HugoFishx/Cat_litter_box/README.md

Cat Litter Box + - Final project of ECE473 @ Umich FA 2021
Group:
    Shiqi Yu
    Haoda Gong
    Yechen Shi
    Ruitao Long
    Tianyang Shi
