HugoFishx/Cat_litter_box/PCB/Draft1.brd

## EAGLE design PCB/Draft1.brd (2021-12-13)

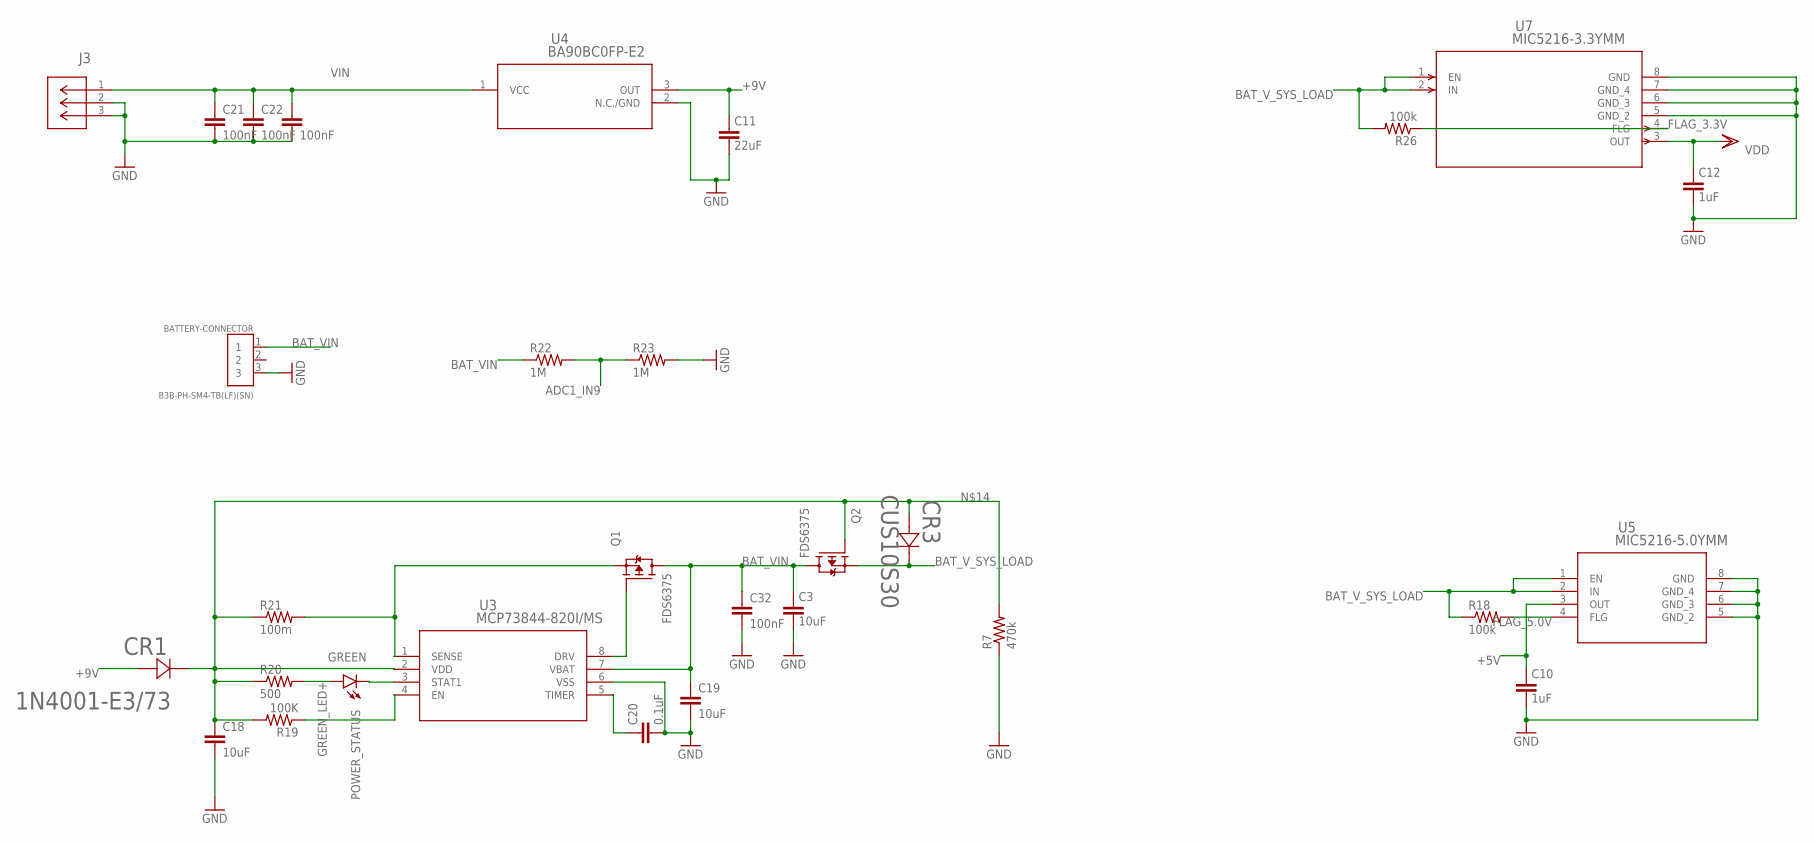
[picture p1: schematic Draft1.sch, sheet 1, Power]

Parts:
BATTERY-CONNECTOR: B3B-PH-SM4-TB(LF)(SN); JST_B3B-PH-SM4-TB(LF)(SN)
C3, C18, C19: 10uF; C0603
C10, C12: 1uF; C0603
C11: 22uF; C0603
C20: 0.1uF; C0603
C21, C22, C23, C32: 100nF; C0603
CR1: 1N4001-E3/73; DO-204AL_VIS
CR3: CUS10S30; USC_TOS
J3: EJ503B; CONN_EJ503B_MPD
POWER_STATUS: GREEN; 1206
Q1, Q2: FDS6375; SOIC127P600X175-8N
R7: 470k; R0603
R18, R26: 100k; R0603
R19: 100K; R0603
R20: 500; R0603
R21: 100m; R0603
R22, R23: 1M; R0603
U3: MCP73844-820I/MS; MSOP8_MC_MCH
U4: BA90BC0FP-E2; TO252-3_ROM
U5: MIC5216-5.0YMM; MSOP8_MM_MCH
U7: MIC5216-3.3YMM; MSOP-8_MM_MCL

Connections:
+5V: C10.1, U5.3 (OUT); also elsewhere on the board
+9V: C11.1, CR1.2, U4.3 (OUT)
ADC1_IN9: R22.2, R23.1; also elsewhere on the board
BAT_VIN: BATTERY-CONNECTOR.1, C3.1, C19.1, C32.1, Q1.5 (D), Q1.6 (D), Q1.7 (D), Q1.8 (D), Q2.5 (D), Q2.6 (D), Q2.7 (D), Q2.8 (D), R22.1, U3.7 (VBAT)
BAT_V_SYS_LOAD: CR3.1 (CATHODE), Q2.1 (S), Q2.2 (S), Q2.3 (S), R18.1, R26.2, U5.1 (EN), U5.2 (IN), U7.1 (EN), U7.2 (IN)
FLAG_3.3V: R26.1, U7.4 (FLG)
FLAG_5.0V: R18.2, U5.4 (FLG)
GND: BATTERY-CONNECTOR.3, C3.2, C10.2, C11.2, C12.2, C18.2, C19.2, C20.2, C21.2, C22.2, C23.2, C32.2, J3.2, J3.3, R7.1, R23.2, U3.6 (VSS), U4.2 (N.C./GND), U5.5 (GND_2), U5.6 (GND_3), U5.7 (GND_4), U5.8 (GND), U7.5 (GND_2), U7.6 (GND_3), U7.7 (GND_4), U7.8 (GND); also elsewhere on the board
GREEN_LED+: POWER_STATUS.A, R20.2
unnamed: C18.1, CR1.1, CR3.2 (ANODE), Q2.4 (G), R7.2, R19.2, R20.1, R21.1, U3.2 (VDD)
unnamed: R19.1, U3.4 (EN)
unnamed: POWER_STATUS.C, U3.3 (STAT1)
unnamed: Q1.4 (G), U3.8 (DRV)
unnamed: Q1.1 (S), Q1.2 (S), Q1.3 (S), R21.2, U3.1 (SENSE)
unnamed: C20.1, U3.5 (TIMER)
VDD: C12.1, U7.3 (OUT); also elsewhere on the board
VIN: C21.1, C22.1, C23.1, J3.1, U4.1 (VCC)

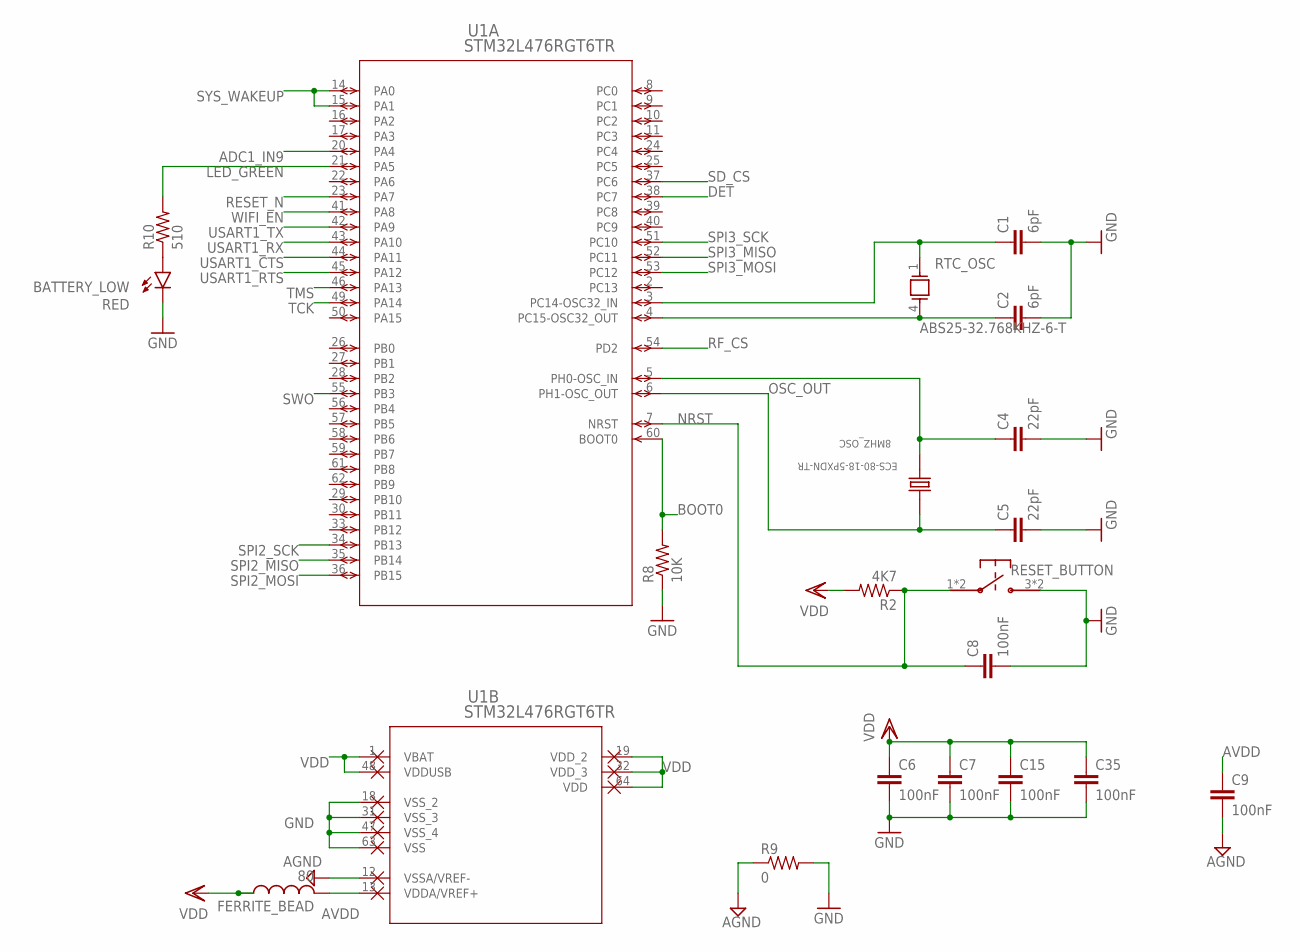
[picture p2: schematic Draft1.sch, sheet 2, MCU]

Parts:
8MHZ_OSC: ECS-80-18-5PXDN-TR; XTAL_ECS-80-18-5PXDN-TR
BATTERY_LOW: RED; 1206
C1, C2: 6pF; C0603
C4, C5: 22pF; C0603
C6, C7, C8, C9, C15, C35: 100nF; C0603
FERRITE_BEAD: 80; L3216C
R2: 4K7; R0603
R8: 10K; R0603
R9: 0; R0603
R10: 510; R0603
RESET_BUTTON: PTS645SM43SMTR
RTC_OSC: ABS25-32.768KHZ-6-T; XTAL_ABS25-32.768KHZ-6-T
U1: STM32L476RGT6TR; LQFP64-10X10MM

Connections:
ADC1_IN9: U1.20 (PA4); also elsewhere on the board
AGND: C9.2, R9.1, U1.12 (VSSA/VREF-)
AVDD: C9.1, FERRITE_BEAD.2, U1.13 (VDDA/VREF+)
BOOT0: R8.2, U1.60 (BOOT0)
DET: U1.38 (PC7); also elsewhere on the board
GND: BATTERY_LOW.C, C1.2, C2.2, C4.2, C5.2, C6.2, C7.2, C8.2, C15.2, C35.2, R8.1, R9.2, RESET_BUTTON.3, RESET_BUTTON.4, U1.18 (VSS_2), U1.31 (VSS_3), U1.47 (VSS_4), U1.63 (VSS); also elsewhere on the board
LED_GREEN: R10.2, U1.21 (PA5)
unnamed: BATTERY_LOW.A, R10.1
unnamed: C1.1, RTC_OSC.1, U1.3 (PC14-OSC32_IN)
unnamed: C2.1, RTC_OSC.4, U1.4 (PC15-OSC32_OUT)
NRST: C8.1, R2.1, RESET_BUTTON.1, RESET_BUTTON.2, U1.7 (NRST); also elsewhere on the board
OSC_IN: 8MHZ_OSC.2, C4.1, U1.5 (PH0-OSC_IN)
OSC_OUT: 8MHZ_OSC.1, C5.1, U1.6 (PH1-OSC_OUT); also elsewhere on the board
RESET_N: U1.23 (PA7); also elsewhere on the board
RF_CS: U1.54 (PD2); also elsewhere on the board
SD_CS: U1.37 (PC6); also elsewhere on the board
SPI2_MISO: U1.35 (PB14); also elsewhere on the board
SPI2_MOSI: U1.36 (PB15); also elsewhere on the board
SPI2_SCK: U1.34 (PB13); also elsewhere on the board
SPI3_MISO: U1.52 (PC11); also elsewhere on the board
SPI3_MOSI: U1.53 (PC12); also elsewhere on the board
SPI3_SCK: U1.51 (PC10); also elsewhere on the board
SWO: U1.55 (PB3); also elsewhere on the board
SYS_WAKEUP: U1.14 (PA0), U1.15 (PA1); also elsewhere on the board
TCK: U1.49 (PA14); also elsewhere on the board
TMS: U1.46 (PA13); also elsewhere on the board
USART1_CTS: U1.44 (PA11); also elsewhere on the board
USART1_RTS: U1.45 (PA12); also elsewhere on the board
USART1_RX: U1.43 (PA10); also elsewhere on the board
USART1_TX: U1.42 (PA9); also elsewhere on the board
VDD: C6.1, C7.1, C15.1, C35.1, FERRITE_BEAD.1, R2.2, U1.1 (VBAT), U1.19 (VDD_2), U1.32 (VDD_3), U1.48 (VDDUSB), U1.64 (VDD); also elsewhere on the board
WIFI_EN: U1.41 (PA8); also elsewhere on the board

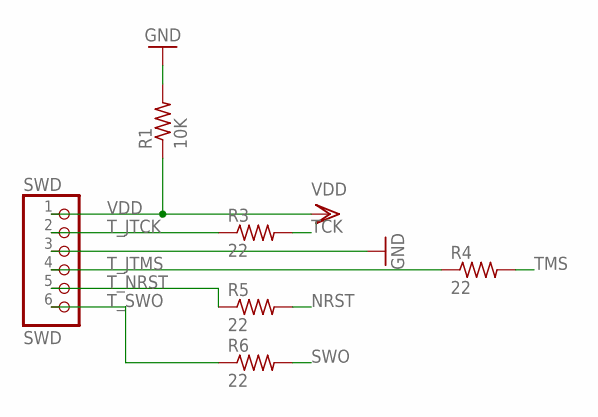
[picture p3: schematic Draft1.sch, sheet 3, STLINK]

Parts:
R1: 10K; R0603
R3, R4, R5, R6: 22; R0603
SWD: SWD; 1X06

Connections:
GND: R1.2, SWD.3; also elsewhere on the board
NRST: R5.2; also elsewhere on the board
SWO: R6.2; also elsewhere on the board
TCK: R3.2; also elsewhere on the board
TMS: R4.2; also elsewhere on the board
T_JTCK: R3.1, SWD.2
T_JTMS: R4.1, SWD.4
T_NRST: R5.1, SWD.5
T_SWO: R6.1, SWD.6
VDD: R1.1, SWD.1; also elsewhere on the board

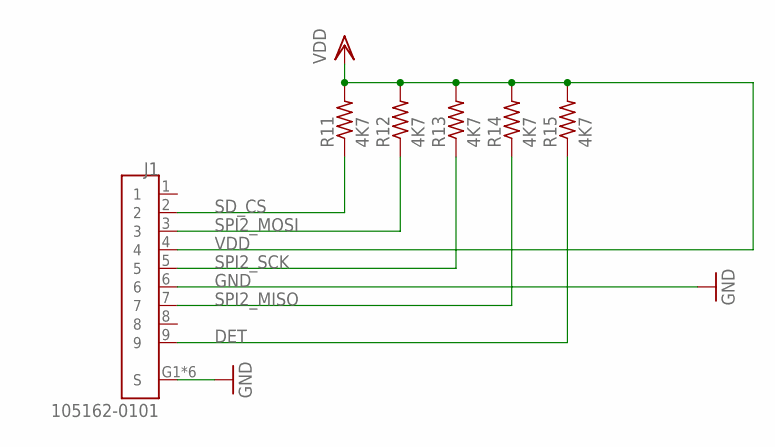
[picture p4: schematic Draft1.sch, sheet 4, microSD]

Parts:
J1: 105162-0101; MOLEX_105162-0101
R11, R12, R13, R14, R15: 4K7; R0603

Connections:
DET: J1.9, R15.1; also elsewhere on the board
GND: J1.6, J1.G1 (S), J1.G2 (S), J1.G3 (S), J1.G4 (S), J1.SH1 (S), J1.SH2 (S); also elsewhere on the board
SD_CS: J1.2, R11.1; also elsewhere on the board
SPI2_MISO: J1.7, R14.1; also elsewhere on the board
SPI2_MOSI: J1.3, R12.1; also elsewhere on the board
SPI2_SCK: J1.5, R13.1; also elsewhere on the board
VDD: J1.4, R11.2, R12.2, R13.2, R14.2, R15.2; also elsewhere on the board

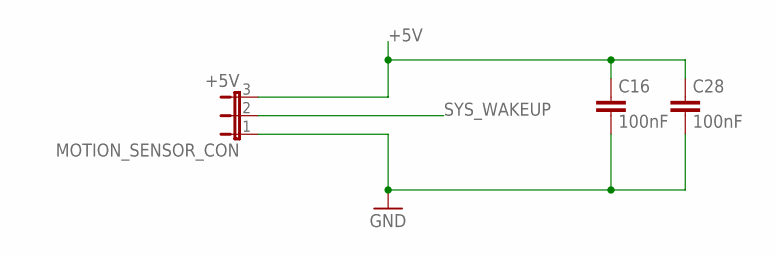
[picture p5: schematic Draft1.sch, sheet 5, Infrared Motion Sensor Connectors]

Parts:
C16, C28: 100nF; C0603
MOTION_SENSOR_CON: +5V; JP2

Connections:
+5V: C16.1, C28.1, MOTION_SENSOR_CON.3; also elsewhere on the board
GND: C16.2, C28.2, MOTION_SENSOR_CON.1; also elsewhere on the board
SYS_WAKEUP: MOTION_SENSOR_CON.2; also elsewhere on the board

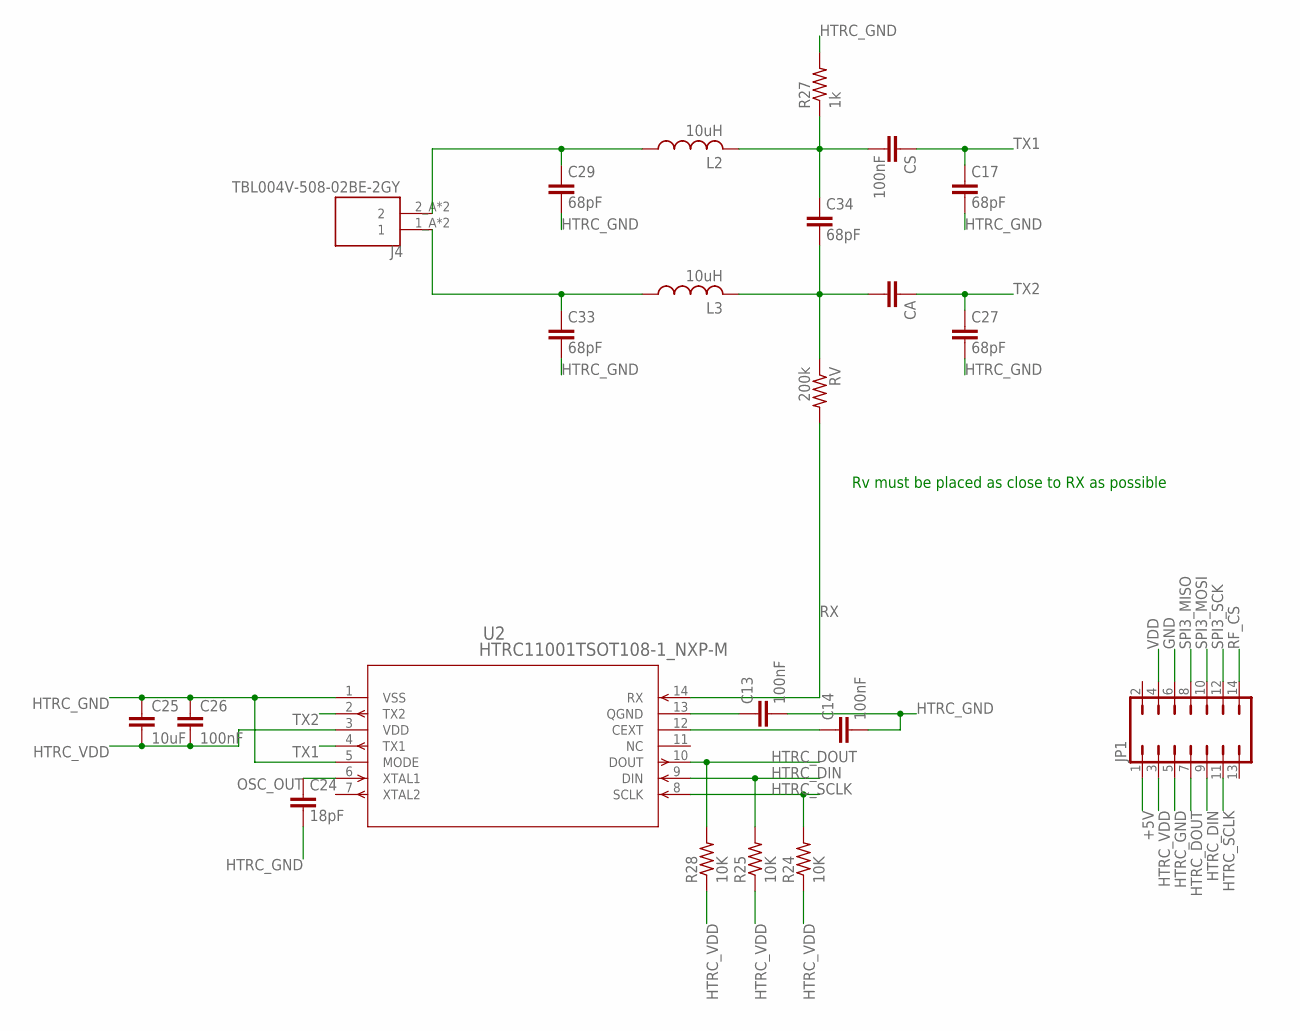
[picture p6: schematic Draft1.sch, sheet 6, RFID Reader]

Parts:
C13, C14, C26: 100nF; C0603
C17, C27, C29, C33, C34: 68pF; C0603
C24: 18pF; C0603
C25: 10uF; C0603
CA: C-EUC0603; C0603
CS: 100nF; C0603
J4: TBL004V-508-02BE-2GY; CUI_TBL004V-508-02BE-2GY
JP1: JP7Q
L2, L3: 10uH; L3225M
R24, R25, R28: 10K; R0603
R27: 1k; R0603
RV: 200k; R0603
U2: HTRC11001TSOT108-1_NXP-M; SOT108-1_NXP-M

Connections:
+5V: JP1.1; also elsewhere on the board
GND: JP1.6; also elsewhere on the board
HTRC_DIN: JP1.9, R25.2, U2.9 (DIN)
HTRC_DOUT: JP1.7, R28.2, U2.10 (DOUT)
HTRC_GND: C13.2, C14.2, C17.2, C24.2, C25.1, C26.1, C27.2, C29.2, C33.2, JP1.5, R27.2, U2.1 (VSS), U2.5 (MODE)
HTRC_SCLK: JP1.11, R24.2, U2.8 (SCLK)
HTRC_VDD: C25.2, C26.2, JP1.3, R24.1, R25.1, R28.1, U2.3 (VDD)
unnamed: C33.1, J4.1_A (1), J4.1_B (1), L3.1
unnamed: C29.1, J4.2_A (2), J4.2_B (2), L2.1
unnamed: C34.1, CS.2, L2.2, R27.1
unnamed: C13.1, U2.13 (QGND)
unnamed: C34.2, CA.2, L3.2, RV.1
unnamed: C14.1, U2.12 (CEXT)
OSC_OUT: C24.1, U2.6 (XTAL1); also elsewhere on the board
RF_CS: JP1.14; also elsewhere on the board
RX: RV.2, U2.14 (RX)
SPI3_MISO: JP1.8; also elsewhere on the board
SPI3_MOSI: JP1.10; also elsewhere on the board
SPI3_SCK: JP1.12; also elsewhere on the board
TX1: C17.1, CS.1, U2.4 (TX1)
TX2: C27.1, CA.1, U2.2 (TX2)
VDD: JP1.4; also elsewhere on the board

Notes on the sheet:
Rv must be placed as close to RX as possible

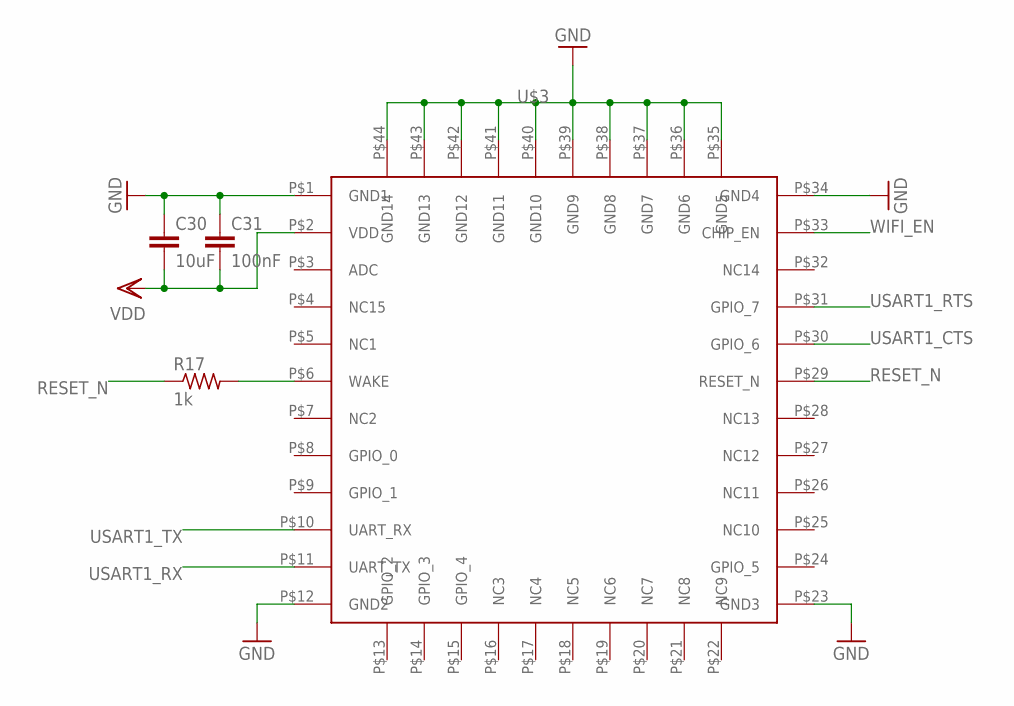
[picture p7: schematic Draft1.sch, sheet 7, WIFI Module]

Parts:
C30: 10uF; C0603
C31: 100nF; C0603
R17: 1k; R0603
U$3: AMW037-2.2.14R

Connections:
GND: C30.1, C31.1, U$3.P$1 (GND1), U$3.P$12 (GND2), U$3.P$23 (GND3), U$3.P$34 (GND4), U$3.P$35 (GND5), U$3.P$36 (GND6), U$3.P$37 (GND7), U$3.P$38 (GND8), U$3.P$39 (GND9), U$3.P$40 (GND10), U$3.P$41 (GND11), U$3.P$42 (GND12), U$3.P$43 (GND13), U$3.P$44 (GND14); also elsewhere on the board
unnamed: R17.2, U$3.P$6 (WAKE)
RESET_N: R17.1, U$3.P$29 (RESET_N); also elsewhere on the board
USART1_CTS: U$3.P$30 (GPIO_6); also elsewhere on the board
USART1_RTS: U$3.P$31 (GPIO_7); also elsewhere on the board
USART1_RX: U$3.P$11 (UART_TX); also elsewhere on the board
USART1_TX: U$3.P$10 (UART_RX); also elsewhere on the board
VDD: C30.2, C31.2, U$3.P$2 (VDD); also elsewhere on the board
WIFI_EN: U$3.P$33 (CHIP_EN); also elsewhere on the board

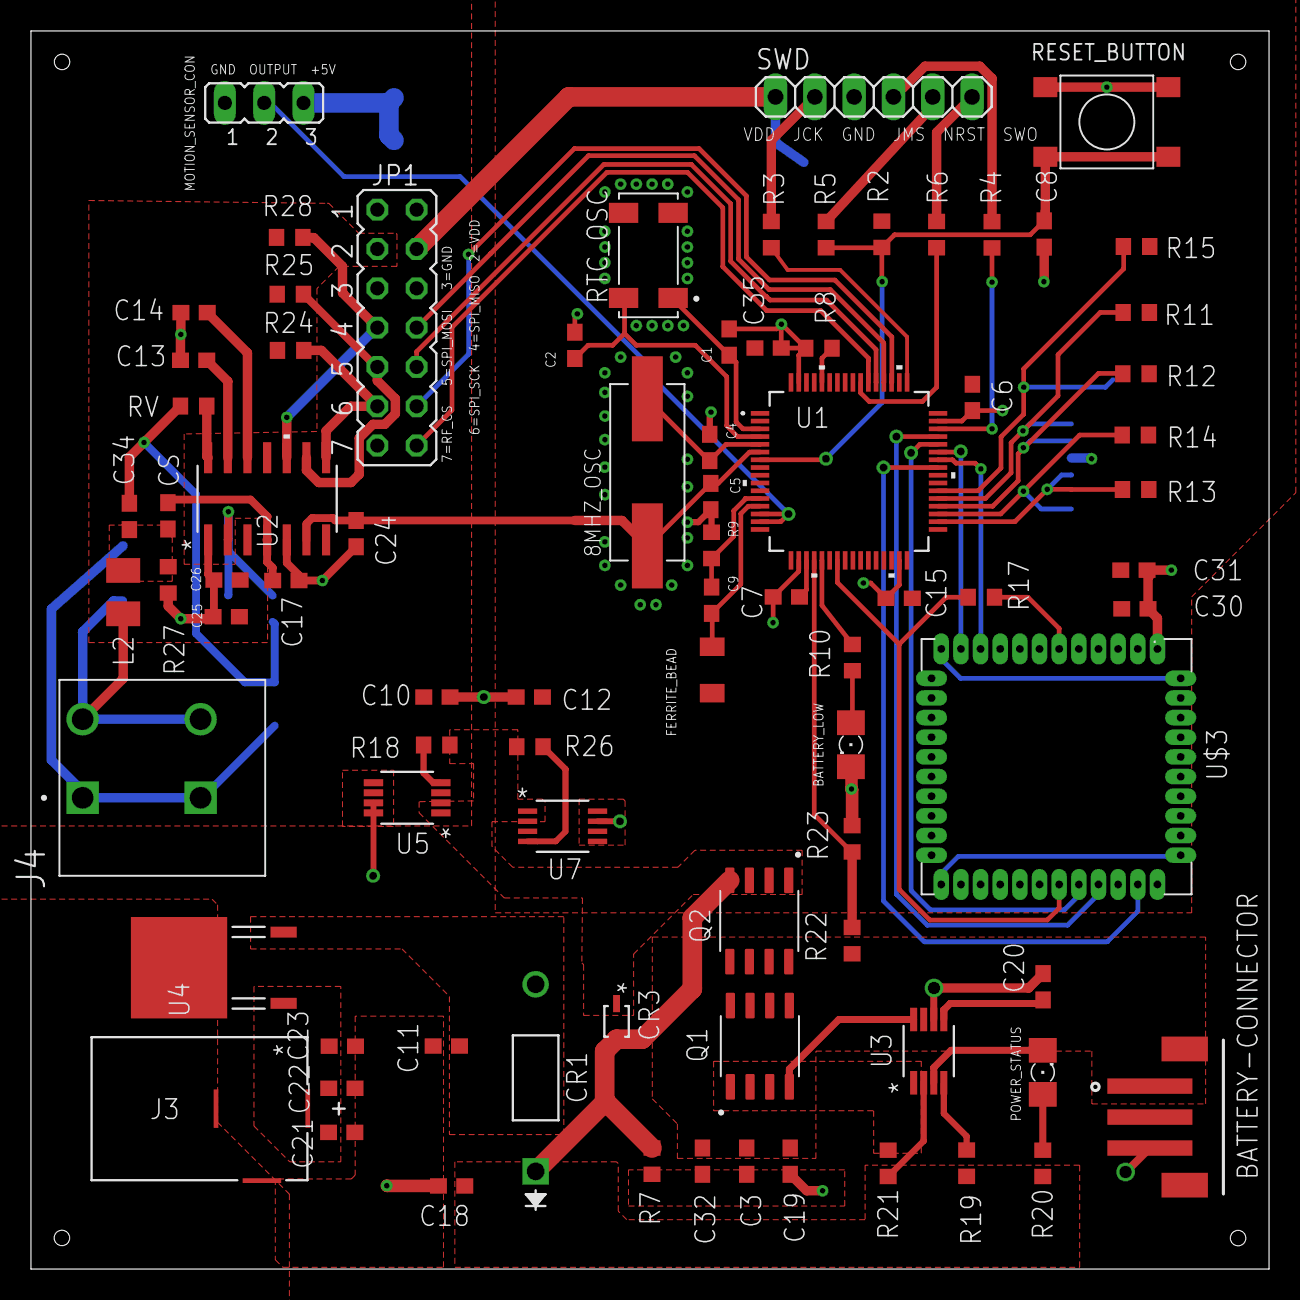
[picture p8: board Draft1.brd from above]

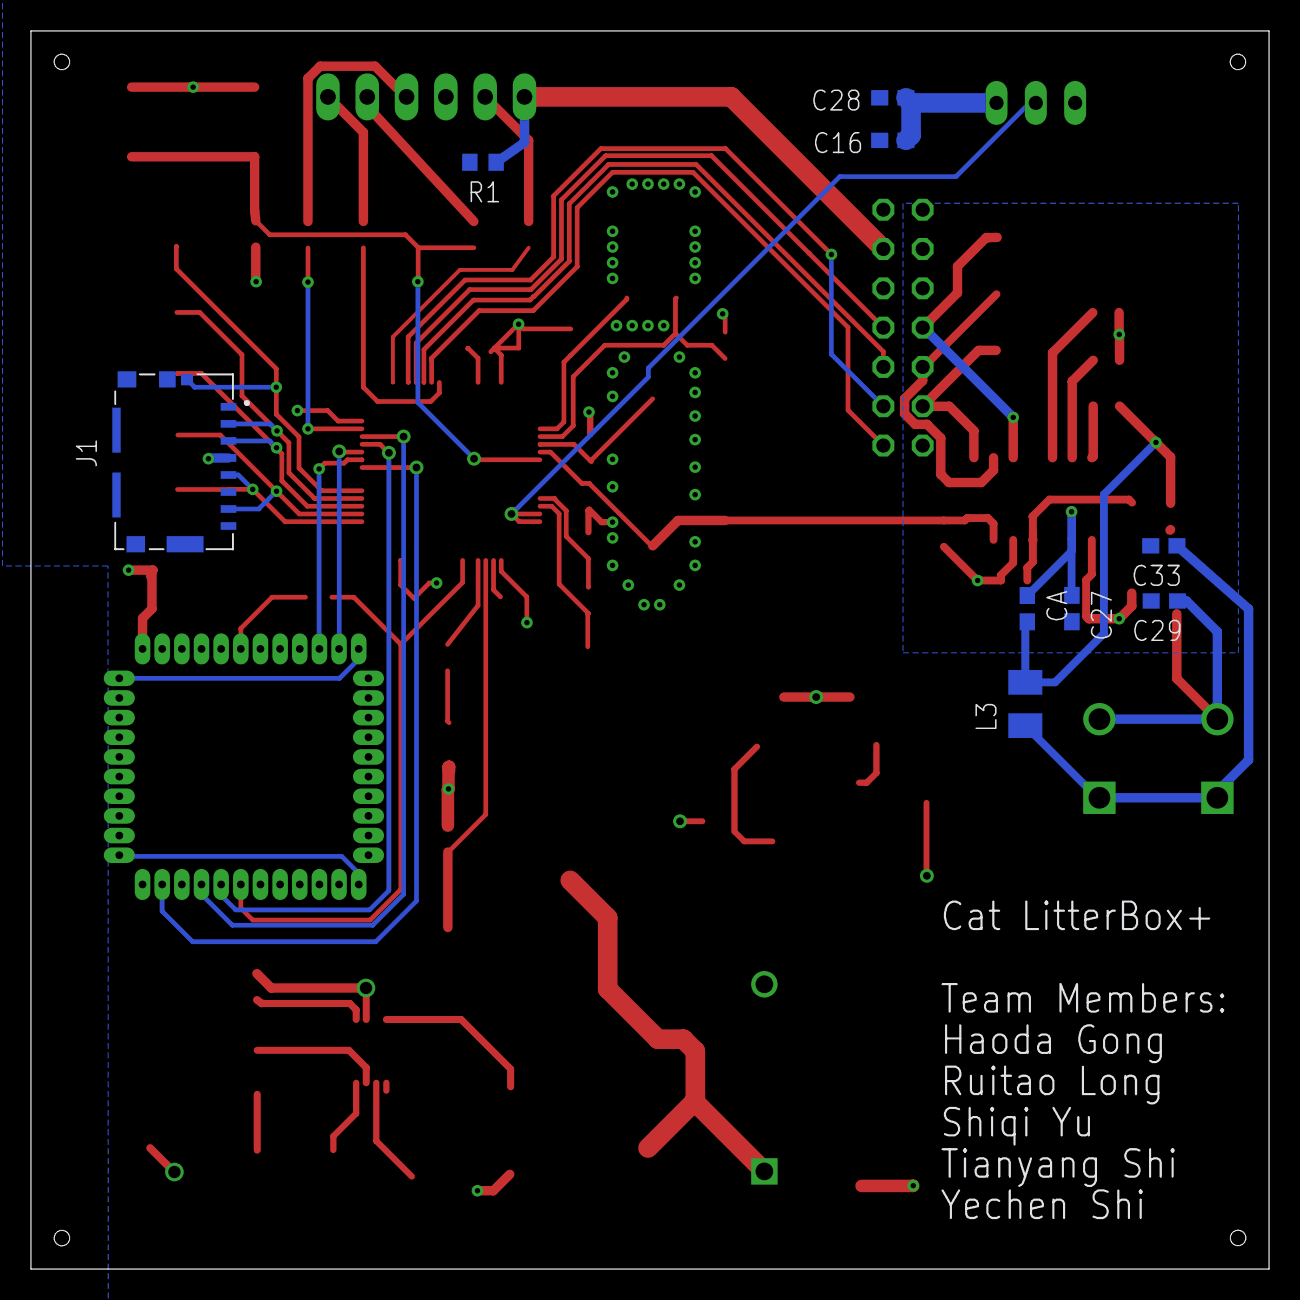
[picture p9: board Draft1.brd from below]

Board: 2 copper layers, 80.0 x 80.0 mm, 91 parts (9 on the bottom side), 65 nets.
