HugoFishx/Cat_litter_box/L4/Core/Src/main.c

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
/* Includes ------------------------------------------------------------------*/
#include "main.h"
#include "fatfs.h"

/* USER CODE BEGIN Includes */
#include <stdio.h>
#include "sdcard.h"
#include <stdarg.h> //for va_list var arg functions
#include <string.h>
/* USER CODE END Includes */

ADC_HandleTypeDef hadc1;

RTC_HandleTypeDef hrtc;

SPI_HandleTypeDef hspi2;
SPI_HandleTypeDef hspi3;

UART_HandleTypeDef huart5;
UART_HandleTypeDef huart1;
UART_HandleTypeDef huart2;

/* USER CODE BEGIN PV */

#define TIME_BYTELENGTH 20

unsigned long start_time;
unsigned long end_time;

struct poop_event new_event;
char real_world_time[TIME_BYTELENGTH];
int cat_in_flag = 0;

char RFID_tag[10] = {'1','2','3','4','5','a','b','c','d','a'};//Value passed from RFID reader

/* USER CODE END PV */

void SystemClock_Config(void);
static void MX_GPIO_Init(void);
static void MX_RTC_Init(void);
static void MX_SPI2_Init(void);
static void MX_USART2_UART_Init(void);
static void MX_ADC1_Init(void);
static void MX_SPI3_Init(void);
static void MX_USART1_UART_Init(void);
static void MX_UART5_Init(void);
/* USER CODE BEGIN PFP */
void myprintf(const char *fmt, ...);
void SDcard_write_event();
void Wifi_write_event();
void Wifi_read_time();
/* USER CODE END PFP */

/* USER CODE BEGIN 0 */

void myprintf(const char *fmt, ...) {
  static char buffer[256];
  va_list args;
  va_start(args, fmt);
  vsnprintf(buffer, sizeof(buffer), fmt, args);
  va_end(args);
  int len = strlen(buffer);
  HAL_UART_Transmit(&huart5, (uint8_t*)buffer, len, -1);

}

void HAL_GPIO_EXTI_Callback(uint16_t GPIO_Pin) {
	if(GPIO_Pin == GPIO_PIN_9) // Pin enabled in pinout is PC9
	{
		if(HAL_GPIO_ReadPin(GPIOC, GPIO_PIN_9)) { // check whether enter or leave
			/*enter handler*/
			myprintf("Cat in!\r\n");
			start_time = HAL_GetTick();
			cat_in_flag = 1;
		  } else {
			/*leave handler*/
			myprintf("Cat out! \r\n");
			end_time = HAL_GetTick();
			memcpy(new_event.cat_id, RFID_tag,10);
			new_event.duration = end_time - start_time;
			myprintf("Duration: %i \r\n", new_event.duration);

			Wifi_write_event();
//			Wifi_read_time();
			SDcard_write_event();


			cat_in_flag = 0;

			// go_to_sleep(); need another interuppt from wifi

		  }
	}
}

void Wifi_write_event(){
	char wifi_buffer[256];
	char itoaBuf[10];

	itoa(new_event.duration,itoaBuf, 10);
	strcat(wifi_buffer, "http_get 192.168.137.123:12345/query/id=");
	strcat(wifi_buffer, new_event.cat_id);
	strcat(wifi_buffer,"&n=");
	strcat(wifi_buffer,itoaBuf);
	strcat(wifi_buffer,"\r");

	HAL_UART_Transmit(&huart1, "stream_close 0\r", strlen("stream_close 0\r"),-1);
	HAL_Delay(50);
	HAL_UART_Transmit(&huart1, wifi_buffer, strlen(wifi_buffer),-1);
	HAL_Delay(50);
	HAL_UART_Transmit(&huart1, "stream_close 0\r", strlen("stream_close 0\r"),-1);
	HAL_Delay(50);

}

void Wifi_read_time(){

	HAL_UART_Receive(&huart1, real_world_time, TIME_BYTELENGTH,-1);

}

void SDcard_write_event(){
	FATFS FatFs; 	//	Fatfs handle
	FRESULT fres; 	//	Result after operations
	FIL fil; 		//	File handle
	UINT bytesWrote;
	char itoaBuf[10];
	fres = f_mount(&FatFs, "", 0); //	1=mount now
	if (fres != FR_OK) {
	myprintf("f_mount error (%i)\r\n", fres);
	return;
//	while(1);
	}

	fres = f_open(&fil, "datalog3.txt", FA_WRITE | FA_OPEN_ALWAYS | FA_OPEN_EXISTING|FA_OPEN_APPEND);
	if(fres == FR_OK) {
		myprintf("I was able to open 'datalog3.txt' for writing\r\n");
	} else {
		myprintf("f_open error (%i)\r\n", fres);
	}

	fres = f_write(&fil, "\r\nID:", strlen("\r\nID:"), &bytesWrote);
	fres = f_write(&fil, new_event.cat_id, strlen(new_event.cat_id), &bytesWrote);
	fres = f_write(&fil, ", Duration:", strlen(", Duration:"), &bytesWrote);
	itoa(new_event.duration,itoaBuf, 10);
	fres = f_write(&fil, itoaBuf, strlen(itoaBuf), &bytesWrote);
//	fres = f_write(&fil, ", Time:", strlen(", Time:"), &bytesWrote);
//	fres = f_write(&fil, real_world_time, strlen(real_world_time), &bytesWrote);
	myprintf("Data Recorded!\n");

	f_close(&fil);

	f_mount(NULL, "", 0);

}

/* USER CODE END 0 */

/**
  * @brief  The application entry point.
  * @retval int
  */
int main(void)
{
  /* MCU Configuration--------------------------------------------------------*/

  /* Reset of all peripherals, Initializes the Flash interface and the Systick. */
  HAL_Init();

  /* Configure the system clock */
  SystemClock_Config();

  /* Initialize all configured peripherals */
  MX_GPIO_Init();
  MX_RTC_Init();
  MX_SPI2_Init();
  MX_USART2_UART_Init();
  MX_FATFS_Init();
  MX_ADC1_Init();
  MX_SPI3_Init();
  MX_USART1_UART_Init();
  MX_UART5_Init();
  /* Infinite loop */
  /* USER CODE BEGIN WHILE */
  while (1)
  {

	  if(cat_in_flag){//		RFID read function here


//		cat_in_flag = 0;
	  }

    /* USER CODE END WHILE */

    /* USER CODE BEGIN 3 */
  }
  /* USER CODE END 3 */
}

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
