HugoFishx/Cat_litter_box/L4/Core/Inc/main.h

#define B1_Pin GPIO_PIN_13
#define B1_GPIO_Port GPIOC
#define USART_TX_Pin GPIO_PIN_2
#define USART_TX_GPIO_Port GPIOA
#define USART_RX_Pin GPIO_PIN_3
#define USART_RX_GPIO_Port GPIOA
#define BATTERY_LOW_LED_Pin GPIO_PIN_5
#define BATTERY_LOW_LED_GPIO_Port GPIOA
#define CS_SD_Pin GPIO_PIN_13
#define CS_SD_GPIO_Port GPIOB
#define DET_Pin GPIO_PIN_14
#define DET_GPIO_Port GPIOB
#define WIFI_EN_Pin GPIO_PIN_8
#define WIFI_EN_GPIO_Port GPIOA
#define TMS_Pin GPIO_PIN_13
#define TMS_GPIO_Port GPIOA
#define TCK_Pin GPIO_PIN_14
#define TCK_GPIO_Port GPIOA
#define SWO_Pin GPIO_PIN_3
#define SWO_GPIO_Port GPIOB
#define SDCARD_SPI_PORT hspi2 // use SPI2
