HugoFishx/Cat_litter_box/Arduino/RFID_HF/RFID_HF.ino

#include <SPI.h>
#include <MFRC522.h> //Download this lib from https://www.arduino.cc/reference/en/libraries/mfrc522/ 
 
#define SS_PIN 10
#define RST_PIN 9
MFRC522 mfrc522(SS_PIN, RST_PIN);   // Create MFRC522 instance.
int count = 0;
 
void setup() 
{
  Serial.begin(9600);   // Initiate a serial communication
  SPI.begin();      // Initiate  SPI bus
  mfrc522.PCD_Init();   // Initiate MFRC522
  Serial.println("Approximate your card to the reader...");
  Serial.println();

}
void loop() 
{
  // Look for new cards
  if ( ! mfrc522.PICC_IsNewCardPresent()) 
  {
    return;
  }
  // Select one of the cards
  if ( ! mfrc522.PICC_ReadCardSerial()) 
  {
    return;
  }
  //Show UID on serial monitor
  Serial.print("UID tag :");
  String content= "";
  byte letter;
  count++;
  for (byte i = 0; i < mfrc522.uid.size; i++) 
  {
     /*Serial.print(mfrc522.uid.uidByte[i] < 0x10 ? " 0" : " ");
     Serial.print(mfrc522.uid.uidByte[i], HEX);*/
     content.concat(String(mfrc522.uid.uidByte[i] < 0x10 ? " 0" : " "));
     content.concat(String(mfrc522.uid.uidByte[i], HEX));
  }
  Serial.print(content); //"content" is the tag ID
  Serial.print(" ,count = ");
  Serial.print(count,DEC);
  Serial.println(); 
  //delay(2000); //delay - we don't want it to keep reading for a single use of litter box
} 
