HugoFishx/Cat_litter_box/(commit log)

2021-10-11 Arduino prototype framework
2021-10-12 Arduino motion sensor handler
2021-10-12 wrap up motion sensor
2021-10-12 ESP32 setup & serial communication & UDP
2021-10-12 weird bug in UDP
    UDP not correct when there are more than 11 bytes in the packet
    [WiFiUDPClient.ino, cat_litter_box.ino]
2021-10-14 Arduino Low Power
2021-10-14 Web Server & UDP fixed & buglog
    [WiFiUDPClient.ino, cat_litter_box.ino]
2021-10-14 Have to put Arduino file in folder with same name
2021-10-15 RFID reader integrated & box->server enabled
    Type "Send" in terminal monitor of Arduino -> Everything in txt will be sent to WiFi via serial -> WiFi send everything to server via UDP -> server shows
2021-10-27 STM32L4 template
2021-10-27 STM32 global var
2021-10-28 Revert "Add files via upload"
    This reverts commit fbd02aaed7ea56a60dacf479b788d6d211fb39fc.
    [main.c]
2021-10-28 Revert "Add files via upload"
    This reverts commit d089e50e1edb4b0ad72dabe849cc619d178d462c.
    [main.h]
2021-10-28 Revert "IDE misc."
    This reverts commit 3cc6d9edf36aeb11f69b9db22a9ecda66d3617ec.
    [Code.ioc, main.c, main.h]
2021-10-28 Revert "STM32 global var"
    This reverts commit 98be9cbf0f283b3a777feb53e50c74585a7911fe.
    [Code.ioc, main.c, main.h]
2021-10-28 Revert "STM32L4 template"
    This reverts commit ddf51d05eda42d09f79252aeee1102c711c99dcc.
    [Code.ioc, main.c, main.h]
2021-10-28 STM32CubeIDE init L4
2021-10-28 Enable PA9 as interrupt pin
2021-10-29 STM32L0 SPI+SDcard test(unfinished)
2021-10-29 SD card lib
    Change include in sdcard.h to match the board
2021-10-29 SD card test from tutorial
    Pin & Serial configuration needed
2021-10-29 Configure SPI for SD card
2021-10-31 SDcard test case + uart5 debug
    Revert "Create 1"
    [Code.ioc, main.c, sdcard.h]
2021-11-11 SDcard write + GPIO interrupt event
2021-11-13 SDcard+motion sensor+wifi
2021-11-14 Revert "Wifi_write_event modified"
    This reverts commit d7a61881acb64a221bb634faf461db6433fc1ccc.
    [main.c]
