HugoFishx/Cat_litter_box/(notices)

Notices in the files:
L4/Core/Src/main.c:
© Copyright (c) 2021 STMicroelectronics.
All rights reserved.
This software component is licensed by ST under Ultimate Liberty license
L4/Core/Inc/main.h:
(C) COPYRIGHT STMicroelectronics *****END OF FILE
parts and their libraries:
COPYRIGHT: Copyright (C) 2021 Ultra Librarian. All rights reserved.
